Brandonh291/MRE481-Senior-Capstone-Project-Solar-Plane/Solar Charger/MPPT Circuit Board.png

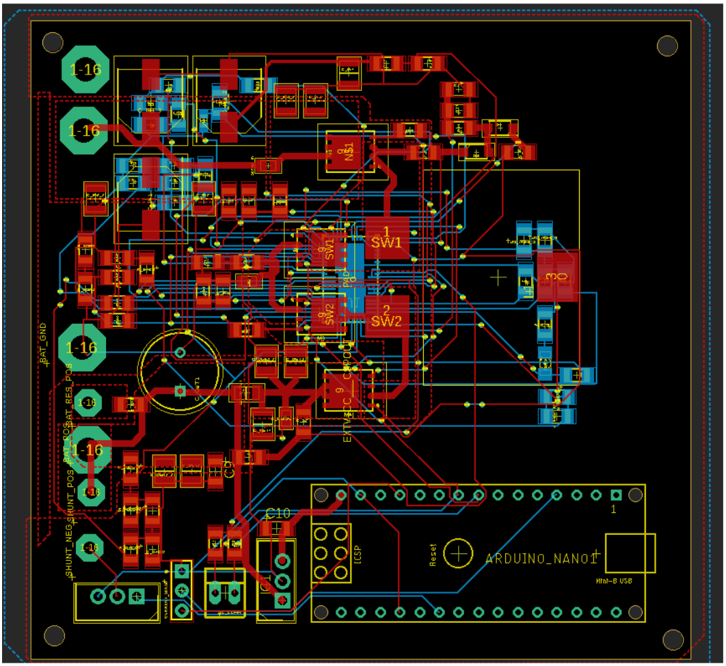
Solar Charger/MPPT Circuit Board.png
