Brandonh291/MRE481-Senior-Capstone-Project-Solar-Plane/README.md

# MRE481-Senior-Capstone-Project-Solar-Plane
