Brandonh291/MRE481-Senior-Capstone-Project-Solar-Plane/Solar Charger/MPPT Charging Circuit Design/Senior Design/Solar Charge Controller.png

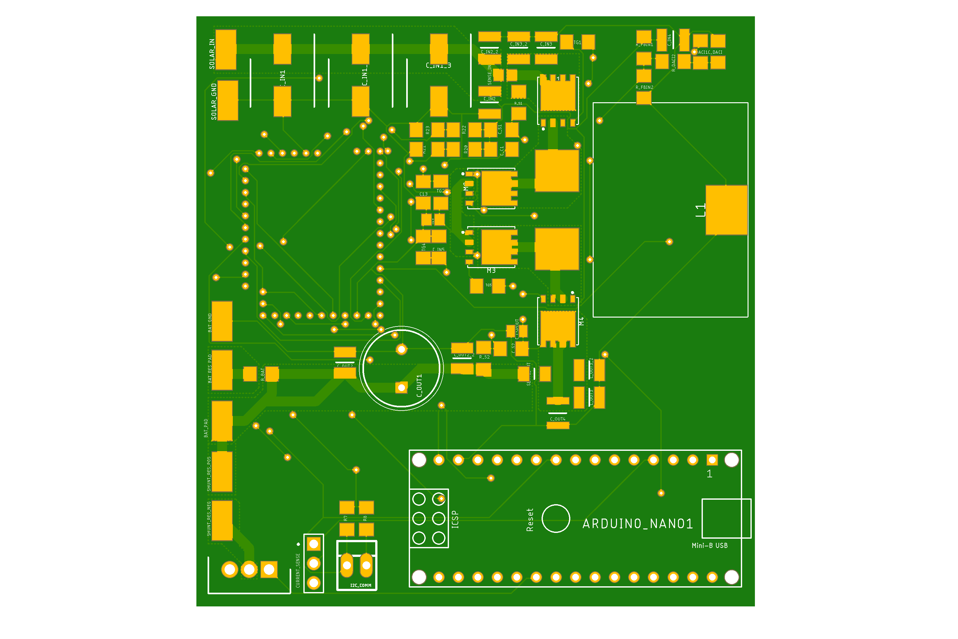
Solar Charger/MPPT Charging Circuit Design/Senior Design/Solar Charge Controller.png
