Brandonh291/MRE481-Senior-Capstone-Project-Solar-Plane/Solar Charger/Simulink Solar Charger and Battery Life Model.png

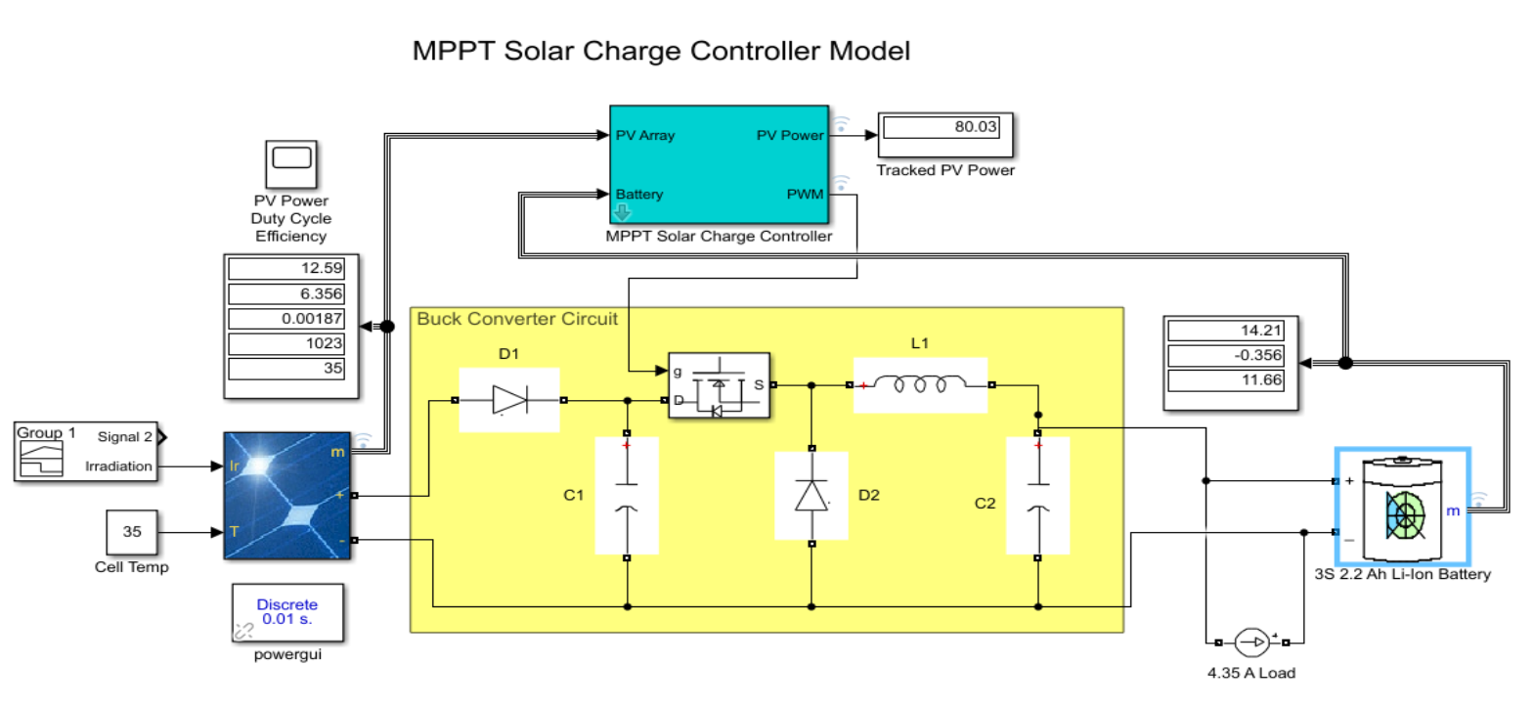
Solar Charger/Simulink Solar Charger and Battery Life Model.png
