Brandonh291/MRE481-Senior-Capstone-Project-Solar-Plane/Solar Charger/MPPT BOM.xlsx

Part | Cost per Part | Number Needed | Cost | Value | Link | Device | Package | Description | ARROW_PART_NUMBER | ARROW_PRICE-STOCK | BUILT_BY | COPYRIGHT | CREATED_BY | DESCRIPTION | DIGI_KEY_PART_NUMBER | HEIGHT | MANUFACTURER | MANUFACTURER_NAME | MANUFACTURER_PART_NUMBER | MF | MOUSER_PART_NUMBER | MOUSER_PRICE-STOCK | MPN | OC_FARNELL | OC_NEWARK | POPULARITY | SOURCELIBRARY | SPICEMODEL | SPICEPREFIX | SPICETYPE | VENDOR
ARDUINO_NANO1 | 4.95$ | 1 | 4.95$ |  |  | ARDUINO_NANO | ARDUINO_NANO | Arduino Nano V3.0
BAT_GND | 0$ | 0 | 0$ |  |  | SMD5 | SMD2,54-5,08 | SMD PAD |  |  |  |  |  |  |  |  |  |  |  |  |  |  |  |  |  | 21
BAT_PAD | 0.00$ | 0 | 0.00$ |  |  | SMD5 | SMD2,54-5,08 | SMD PAD |  |  |  |  |  |  |  |  |  |  |  |  |  |  |  |  |  | 21
BAT_RES_PAD | 0.00$ | 0 | 0.00$ |  |  | SMD5 | SMD2,54-5,08 | SMD PAD |  |  |  |  |  |  |  |  |  |  |  |  |  |  |  |  |  | 21
C1 | 0.12$ | 1 | 0.12$ | 100nF | https://www.mouser.com/ProductDetail/Vishay-Vitramon/VJ1206Y104JXAAR/ | CC1206 | C1206 | CAPACITOR, European symbol |  |  |  |  |  |  |  |  |  |  |  |  |  |  |  |  |  |  |  | NONE | C
C2 | 0.11$ | 1 | 0.11$ | 4.7uF x 2 | https://www.mouser.com/ProductDetail/Walsin/1206X475K250CT/ | CC1206 | C1206 | CAPACITOR, European symbol |  |  |  |  |  |  |  |  |  |  |  |  |  |  |  |  |  |  |  | NONE | C
C3 | 0.10$ | 1 | 0.10$ | 1uF | https://www.mouser.com/ProductDetail/Walsin/1206B105K250CT/ | CC1206 | C1206 | CAPACITOR, European symbol |  |  |  |  |  |  |  |  |  |  |  |  |  |  |  |  |  |  |  | NONE | C
C4 | 0.11$ | 1 | 0.11$ | 4.7uF | https://www.mouser.com/ProductDetail/Walsin/1206X475K250CT/ | CC1206 | C1206 | CAPACITOR, European symbol |  |  |  |  |  |  |  |  |  |  |  |  |  |  |  |  |  |  |  | NONE | C
C5 | 0.10$ | 1 | 0.10$ | 68nF | https://www.mouser.com/ProductDetail/Samsung-Electro-Mechanics/CL10B683KB8WPNC/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 | CC1206 | C0603 | CAPACITOR, European symbol |  |  |  |  |  |  |  |  |  |  |  |  |  |  |  |  |  |  |  | NONE | C
C6 | 0.10$ | 1 | 0.10$ | 220pF | https://www.mouser.com/ProductDetail/Walsin/1206B221K202CT/?qs=fIkAfuXiAQJKri8ChW5wGw%3D%3D | CC1206 | C1206 | CAPACITOR, European symbol |  |  |  |  |  |  |  |  |  |  |  |  |  |  |  |  |  |  |  | NONE | C
C7 | 0.10$ | 1 | 0.10$ | 8.2nF | https://www.mouser.com/ProductDetail/Walsin/1206B822K500CT/?qs=fIkAfuXiAQI%2FF3tws0uD%252BQ%3D%3D | CC1206 | C1206 | CAPACITOR, European symbol |  |  |  |  |  |  |  |  |  |  |  |  |  |  |  |  |  |  |  | NONE | C
C8 | 0.39$ | 1 | 0.39$ | 100nF | https://www.mouser.com/ProductDetail/Vishay-Vitramon/VJ1206Y104JXAAR/ | CC1206 | C1206 | CAPACITOR, European symbol |  |  |  |  |  |  |  |  |  |  |  |  |  |  |  |  |  |  |  | NONE | C
C11 | 0.11$ | 1 | 0.11$ | 4.7uF x 2 | https://www.mouser.com/ProductDetail/Walsin/1206X475K250CT/ | CC1206 | C1206 | CAPACITOR, European symbol |  |  |  |  |  |  |  |  |  |  |  |  |  |  |  |  |  |  |  | NONE | C
C13 | 0.11$ | 1 | 0.11$ | 3.3n | https://www.mouser.com/ProductDetail/Vishay-Vitramon/VJ1206Y332JXAAC/?qs=n%2FdCh0j7G57pZ1MJ9O0z7g%3D%3D | CC1206 | C1206 | CAPACITOR, European symbol |  |  |  |  |  |  |  |  |  |  |  |  |  |  |  |  |  |  |  | NONE | C
CURRENT_SENSE | 0.00$ | 0 | 0.00$ | 61300311121 | https://www.mouser.com/ProductDetail/Wurth-Elektronik/61300311121/ | 61300311121 | 61300311121 | CONN HEADER VERT 3POS 2.54MM |  |  |  |  | PCBLayout.com |  | 732-5316-ND |  | Wurth Electronics Inc. |  |  |  |  |  | 61300311121
C_C1 | 0.12$ | 1 | 0.12$ | 100nF | https://www.mouser.com/ProductDetail/Vishay-Vitramon/VJ1206Y104JXAAR/ | CC1206 | C1206 | CAPACITOR, European symbol |  |  |  |  |  |  |  |  |  |  |  |  |  |  |  |  |  |  |  | NONE | C
C_CSPOUT | 0.25$ | 1 | 0.25$ | 08055C104J4Z4A | https://www.mouser.com/ProductDetail/AVX/08055C104J4Z4A/?qs=xMTsDkQFXIw7L45hGtT%2Fjg%3D%3D | 08055C104J4Z4A | CAPC2012X127N | Cap Ceramic 0.1uF 50V X7R 5% SMD 0805 FlexiTerm 125C Paper T/R | 08055C104J4Z4A | https://www.arrow.com/en/products/08055c104j4z4a/avx |  |  |  | Cap Ceramic 0.1uF 50V X7R 5% SMD 0805 FlexiTerm 125C Paper T/R |  | 1.27mm |  | AVX | 08055C104J4Z4A |  | 581-08055C104J4Z4A | https://www.mouser.co.uk/ProductDetail/AVX/08055C104J4Z4A?qs=xMTsDkQFXIw7L45hGtT%2Fjg%3D%3D
C_DACI | 0.38$ | 1 | 0.38$ | 307nF | https://www.mouser.com/ProductDetail/Yageo/CC1206KKX7R0BB334/?qs=tS%2FAHvPQ%2F57JFCsk3C6blg%3D%3D | CC1206 | C1206 | CAPACITOR, European symbol |  |  |  |  |  |  |  |  |  |  |  |  |  |  |  |  |  |  |  | NONE | C
C_DACO | 0.33$ | 1 | 0.33$ | 81.445nF (82nF) | https://www.mouser.com/ProductDetail/AVX/12061C823KAT2A/?qs=iALvLSEVlb9T5XvBHTbaPA%3D%3D | CC1206 | C1206 | CAPACITOR, European symbol |  |  |  |  |  |  |  |  |  |  |  |  |  |  |  |  |  |  |  | NONE | C
C_IMON_IN | 0.10$ | 1 | 0.10$ | 10nF | https://www.mouser.com/ProductDetail/Walsin/1206B103K500CT/?qs=fIkAfuXiAQIBfhuh%2Ff3kSw%3D%3D | CC1206 | C1206 | CAPACITOR, European symbol |  |  |  |  |  |  |  |  |  |  |  |  |  |  |  |  |  |  |  | NONE | C
C_IMON_OUT | 0.10$ | 1 | 0.10$ | 10nF | https://www.mouser.com/ProductDetail/Walsin/1206B103K500CT/?qs=fIkAfuXiAQIBfhuh%2Ff3kSw%3D%3D | CC1206 | C1206 | CAPACITOR, European symbol |  |  |  |  |  |  |  |  |  |  |  |  |  |  |  |  |  |  |  | NONE | C
C_IN1 | 3.30$ | 1 | 3.30$ | 63HVH33M | https://www.mouser.com/ProductDetail/Panasonic/63SXV33M/?qs=LkACrQhHtvC3OEKZ9h0MUg%3D%3D | 63HVH33M | CAPAE1025X1080N | Hybrid Conductive Polymer Type / Surface Mount Type |  |  |  |  |  | Hybrid Conductive Polymer Type / Surface Mount Type |  | 10.8mm |  | SANYO | 63HVH33M
C_IN1_2 | 3.30$ | 1 | 3.30$ | 63HVH33M | https://www.mouser.com/ProductDetail/Panasonic/63SXV33M/?qs=LkACrQhHtvC3OEKZ9h0MUg%3D%3D | 63HVH33M | CAPAE1025X1080N | Hybrid Conductive Polymer Type / Surface Mount Type |  |  |  |  |  | Hybrid Conductive Polymer Type / Surface Mount Type |  | 10.8mm |  | SANYO | 63HVH33M
C_IN1_3 | 3.30$ | 1 | 3.30$ | 63HVH33M | https://www.mouser.com/ProductDetail/Panasonic/63SXV33M/?qs=LkACrQhHtvC3OEKZ9h0MUg%3D%3D | 63HVH33M | CAPAE1025X1080N | Hybrid Conductive Polymer Type / Surface Mount Type |  |  |  |  |  | Hybrid Conductive Polymer Type / Surface Mount Type |  | 10.8mm |  | SANYO | 63HVH33M
C_IN2 | 0.25$ | 1 | 0.25$ | 2.2uf x 2 | https://www.mouser.com/ProductDetail/187-CL31B225KBHNFNE/ | 12101C225KAT2A | CAPC3325X279N | AVX 1210 Standard 2.2 | 12101C225KAT2A | https://www.arrow.com/en/products/12101c225kat2a/avx |  |  |  | AVX 1210 Standard 2.2 |  | 2.79mm |  | AVX | 12101C225KAT2A |  | 581-12101C225KAT2A | https://www.mouser.co.uk/ProductDetail/AVX/12101C225KAT2A?qs=sEn5VCT5Piadpj%252BmhssWtA%3D%3D
C_IN2_2 | 0.25$ | 1 | 0.25$ | 2.2uf x 2 | https://www.mouser.com/ProductDetail/187-CL31B225KBHNFNE/ | 12101C225KAT2A | CAPC3325X279N | AVX 1210 Standard 2.2 | 12101C225KAT2A | https://www.arrow.com/en/products/12101c225kat2a/avx |  |  |  | AVX 1210 Standard 2.2 |  | 2.79mm |  | AVX | 12101C225KAT2A |  | 581-12101C225KAT2A | https://www.mouser.co.uk/ProductDetail/AVX/12101C225KAT2A?qs=sEn5VCT5Piadpj%252BmhssWtA%3D%3D
C_IN3 | 0.25$ | 1 | 0.25$ | 2.2uf x 2 | https://www.mouser.com/ProductDetail/187-CL31B225KBHNFNE/ | 12101C225KAT2A | CAPC3325X279N | AVX 1210 Standard 2.2 | 12101C225KAT2A | https://www.arrow.com/en/products/12101c225kat2a/avx |  |  |  | AVX 1210 Standard 2.2 |  | 2.79mm |  | AVX | 12101C225KAT2A |  | 581-12101C225KAT2A | https://www.mouser.co.uk/ProductDetail/AVX/12101C225KAT2A?qs=sEn5VCT5Piadpj%252BmhssWtA%3D%3D
C_IN3_2 | 0.25$ | 1 | 0.25$ | 2.2uf x 2 | https://www.mouser.com/ProductDetail/187-CL31B225KBHNFNE/ | 12101C225KAT2A | CAPC3325X279N | AVX 1210 Standard 2.2 | 12101C225KAT2A | https://www.arrow.com/en/products/12101c225kat2a/avx |  |  |  | AVX 1210 Standard 2.2 |  | 2.79mm |  | AVX | 12101C225KAT2A |  | 581-12101C225KAT2A | https://www.mouser.co.uk/ProductDetail/AVX/12101C225KAT2A?qs=sEn5VCT5Piadpj%252BmhssWtA%3D%3D
C_IN4 | 0.25$ | 1 | 0.25$ | 2.2uf | https://www.mouser.com/ProductDetail/187-CL31B225KBHNFNE/ | 12101C225KAT2A | CAPC3325X279N | AVX 1210 Standard 2.2 | 12101C225KAT2A | https://www.arrow.com/en/products/12101c225kat2a/avx |  |  |  | AVX 1210 Standard 2.2 |  | 2.79mm |  | AVX | 12101C225KAT2A |  | 581-12101C225KAT2A | https://www.mouser.co.uk/ProductDetail/AVX/12101C225KAT2A?qs=sEn5VCT5Piadpj%252BmhssWtA%3D%3D
C_IN5 | 0.11$ | 1 | 0.11$ | 3.3n | https://www.mouser.com/ProductDetail/Vishay-Vitramon/VJ1206Y332JXAAC/?qs=n%2FdCh0j7G57pZ1MJ9O0z7g%3D%3D | CC1206 | C1206 | CAPACITOR, European symbol |  |  |  |  |  |  |  |  |  |  |  |  |  |  |  |  |  |  |  | NONE | C
C_IN6 | 0.10$ | 1 | 0.10$ | 220n | https://www.mouser.com/ProductDetail/Walsin/1206B224K500CT/ | CC1206 | C1206 | CAPACITOR, European symbol |  |  |  |  |  |  |  |  |  |  |  |  |  |  |  |  |  |  |  | NONE | C
C_IN7 | 0.10$ | 1 | 0.10$ | 220n | https://www.mouser.com/ProductDetail/Walsin/1206B224K500CT/ | CC1206 | C1206 | CAPACITOR, European symbol |  |  |  |  |  |  |  |  |  |  |  |  |  |  |  |  |  |  |  | NONE | C
C_OUT1 | 0.71$ | 1 | 0.71$ | EEUFR1H151B | https://www.mouser.com/ProductDetail/Panasonic/EEU-FR1H151B/ | EEUFR1H151B | CAPPRD500W65D1000H1400 | Cap Aluminum Lytic 150uF 50V 20% (10 X 12.5mm) Radial 5mm 1170mA 6000h 105C Ammo |  |  |  |  |  | Cap Aluminum Lytic 150uF 50V 20% (10 X 12.5mm) Radial 5mm 1170mA 6000h 105C Ammo |  | 14mm |  | Panasonic | EEUFR1H151B
C_OUT2 | 1.06$ | 1 | 1.06$ | GRM32ER7YA106KA12K | https://www.mouser.com/ProductDetail/Murata-Electronics/GRM32ER7YA106KA12K/ | GRM32ER7YA106KA12K | CAPC3225X270N | Multilayer Ceramic Capacitors MLCC - SMD/SMT | GRM32ER7YA106KA12K | https://www.arrow.com/en/products/grm32er7ya106ka12k/murata-manufacturing |  |  |  | Multilayer Ceramic Capacitors MLCC - SMD/SMT |  | 2.7mm |  | Murata Electronics | GRM32ER7YA106KA12K |  | 81-GRM32ER7YA106KA2K | https://www.mouser.com/Search/Refine.aspx?Keyword=81-GRM32ER7YA106KA2K
C_OUT2_2 | 1.06$ | 1 | 1.06$ | GRM32ER7YA106KA12K | https://www.mouser.com/ProductDetail/Murata-Electronics/GRM32ER7YA106KA12K/ | GRM32ER7YA106KA12K | CAPC3225X270N | Multilayer Ceramic Capacitors MLCC - SMD/SMT | GRM32ER7YA106KA12K | https://www.arrow.com/en/products/grm32er7ya106ka12k/murata-manufacturing |  |  |  | Multilayer Ceramic Capacitors MLCC - SMD/SMT |  | 2.7mm |  | Murata Electronics | GRM32ER7YA106KA12K |  | 81-GRM32ER7YA106KA2K | https://www.mouser.com/Search/Refine.aspx?Keyword=81-GRM32ER7YA106KA2K
C_OUT3 | 1.06$ | 1 | 1.06$ | GRM32ER7YA106KA12K | https://www.mouser.com/ProductDetail/Murata-Electronics/GRM32ER7YA106KA12K/ | GRM32ER7YA106KA12K | CAPC3225X270N | Multilayer Ceramic Capacitors MLCC - SMD/SMT | GRM32ER7YA106KA12K | https://www.arrow.com/en/products/grm32er7ya106ka12k/murata-manufacturing |  |  |  | Multilayer Ceramic Capacitors MLCC - SMD/SMT |  | 2.7mm |  | Murata Electronics | GRM32ER7YA106KA12K |  | 81-GRM32ER7YA106KA2K | https://www.mouser.com/Search/Refine.aspx?Keyword=81-GRM32ER7YA106KA2K
C_OUT3_2 | 1.06$ | 1 | 1.06$ | GRM32ER7YA106KA12K | https://www.mouser.com/ProductDetail/Murata-Electronics/GRM32ER7YA106KA12K/ | GRM32ER7YA106KA12K | CAPC3225X270N | Multilayer Ceramic Capacitors MLCC - SMD/SMT | GRM32ER7YA106KA12K | https://www.arrow.com/en/products/grm32er7ya106ka12k/murata-manufacturing |  |  |  | Multilayer Ceramic Capacitors MLCC - SMD/SMT |  | 2.7mm |  | Murata Electronics | GRM32ER7YA106KA12K |  | 81-GRM32ER7YA106KA2K | https://www.mouser.com/Search/Refine.aspx?Keyword=81-GRM32ER7YA106KA2K
C_OUT4 | 0.34$ | 1 | 0.34$ | CGA6L2X7R1H105K160AA | https://www.mouser.com/ProductDetail/TDK/CGA6L2X7R1H105K160AA/ | CGA6L2X7R1H105K160AA | CAPC3225X280N | TDK CGA6L2X7R1H105K160AA 1F MLCC 50V dc +/-10% Tolerance SMD | CGA6L2X7R1H105K160AA | https://www.arrow.com/en/products/cga6l2x7r1h105k160aa/tdk |  |  |  | TDK CGA6L2X7R1H105K160AA 1F MLCC 50V dc +/-10% Tolerance SMD |  | 2.8mm |  | TDK | CGA6L2X7R1H105K160AA |  | 810-CGA6L2X7R1H105K | https://www.mouser.com/Search/Refine.aspx?Keyword=810-CGA6L2X7R1H105K
C_S1 | 0.16$ | 1 | 0.16$ | 470n | https://www.mouser.com/ProductDetail/Vishay-Vitramon/VJ1206Y474KXATW1BC/ | CC1206 | C1206 | CAPACITOR, European symbol |  |  |  |  |  |  |  |  |  |  |  |  |  |  |  |  |  |  |  | NONE | C
C_S2 | 0.16$ | 1 | 0.16$ | 470nF | https://www.mouser.com/ProductDetail/Vishay-Vitramon/VJ1206Y474KXATW1BC/ | CC1206 | C1206 | CAPACITOR, European symbol |  |  |  |  |  |  |  |  |  |  |  |  |  |  |  |  |  |  |  | NONE | C
D3 | 0.83$ | 1 | 0.83$ | CMMR1U-02_TR | https://www.mouser.com/ProductDetail/Central-Semiconductor/CMMR1U-02-TR-PBFREE/ | CMMR1U-02_TR | SODFL3818X108N | Rectifiers Ultra Fast Rectifier Single |  |  |  |  |  | Rectifiers Ultra Fast Rectifier Single |  | 1.08mm |  | Central Semiconductor | CMMR1U-02 TR |  | 610-CMMR1U-02 | https://www.mouser.com/Search/Refine.aspx?Keyword=610-CMMR1U-02
D4 | 0.83$ | 1 | 0.83$ | CMMR1U-02_TR | https://www.mouser.com/ProductDetail/Central-Semiconductor/CMMR1U-02-TR-PBFREE/ | CMMR1U-02_TR | SODFL3818X108N | Rectifiers Ultra Fast Rectifier Single |  |  |  |  |  | Rectifiers Ultra Fast Rectifier Single |  | 1.08mm |  | Central Semiconductor | CMMR1U-02 TR |  | 610-CMMR1U-02 | https://www.mouser.com/Search/Refine.aspx?Keyword=610-CMMR1U-02
D_S | 0.43$ | 1 | 0.43$ | MMBT5550L | https://www.mouser.com/ProductDetail/Stanley-Electric/BG1102W-TR/?qs=byeeYqUIh0NA%2FIv6R5YGDA%3D%3D | LED_E | LED_1206 | LED |  |  |  |  |  |  |  |  |  |  |  |  |  |  |  |  |  |  |  | NONE | D | diode
I2C_COMM | 0.16$ | 1 | 0.16$ | 22-23-2021 | https://www.mouser.com/ProductDetail/Molex/22-23-2021/ | 22-23-2021 | 22-23-2021 | .100 (2.54mm) Center Header - 2 Pin" |  |  |  |  |  |  |  |  |  |  |  | MOLEX |  |  | 22-23-2021 | 1462926 | 25C3832 | 40
L1 | 4.87$ | 1 | 4.87$ | 10u | https://www.mouser.com/ProductDetail/Coilcraft/SER2915H-103KL/ | SER2915H-103KL | SER2900 | Fixed Inductors SER2915H Hi Current 10 uH 10 % 30 A |  |  |  |  |  | Fixed Inductors SER2915H Hi Current 10 uH 10 % 30 A |  | mm |  | COILCRAFT | SER2915H-103KL |  | 994-SER2915H-103KL | https://www.mouser.co.uk/ProductDetail/Coilcraft/SER2915H-103KL?qs=zCSbvcPd3pbm6JOcdM0KSg%3D%3D
M1 | 0.83$ | 1 | 0.83$ | BSC028N06NS | https://www.mouser.com/ProductDetail/Infineon-Technologies/BSC028N06NS/?qs=EUA%2Fg8wssK3HptIwN0%252BK7A%3D%3D | BSC028N06NS | PG-TDSON-8_1 | MOSFET N-Channel 60V 100A OptiMOS TDSON8 Infineon BSC028N06NS N-channel MOSFET Transistor, 100 A, 60 V, 8-Pin TDSON |  |  |  |  |  | MOSFET N-Channel 60V 100A OptiMOS TDSON8 Infineon BSC028N06NS N-channel MOSFET Transistor, 100 A, 60 V, 8-Pin TDSON |  | mm |  | Infineon | BSC028N06NS |  | 726-BSC028N06NS | https://www.mouser.co.uk/ProductDetail/Infineon-Technologies/BSC028N06NS?qs=EUA%2Fg8wssK3HptIwN0%252BK7A%3D%3D
M2 | 0.83$ | 1 | 0.83$ | BSC028N06NS | https://www.mouser.com/ProductDetail/Infineon-Technologies/BSC028N06NS/?qs=EUA%2Fg8wssK3HptIwN0%252BK7A%3D%3D | BSC028N06NS | PG-TDSON-8_1 | MOSFET N-Channel 60V 100A OptiMOS TDSON8 Infineon BSC028N06NS N-channel MOSFET Transistor, 100 A, 60 V, 8-Pin TDSON |  |  |  |  |  | MOSFET N-Channel 60V 100A OptiMOS TDSON8 Infineon BSC028N06NS N-channel MOSFET Transistor, 100 A, 60 V, 8-Pin TDSON |  | mm |  | Infineon | BSC028N06NS |  | 726-BSC028N06NS | https://www.mouser.co.uk/ProductDetail/Infineon-Technologies/BSC028N06NS?qs=EUA%2Fg8wssK3HptIwN0%252BK7A%3D%3D
M3 | 0.83$ | 1 | 0.83$ | BSC059N04LSGATMA1 | https://www.mouser.com/ProductDetail/Infineon-Technologies/BSC059N04LSGATMA1/?qs=OwbwYO03UsIeXsXqrPLFnQ%3D%3D | BSC059N04LSGATMA1 | BSC080N03LSG | MOSFET N-Ch 40V 73A TDSON-8 OptiMOS 3 | BSC059N04LSGATMA1 | https://www.arrow.com/en/products/bsc059n04lsgatma1/infineon-technologies-ag |  |  |  | MOSFET N-Ch 40V 73A TDSON-8 OptiMOS 3 |  | mm |  | Infineon | BSC059N04LSGATMA1 |  | 726-BSC059N04LSGATMA | https://www.mouser.co.uk/ProductDetail/Infineon-Technologies/BSC059N04LSGATMA1/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
M4 | 0.83$ | 1 | 0.83$ | BSC059N04LSGATMA1 | https://www.mouser.com/ProductDetail/Infineon-Technologies/BSC059N04LSGATMA1/?qs=OwbwYO03UsIeXsXqrPLFnQ%3D%3D | BSC059N04LSGATMA1 | BSC080N03LSG | MOSFET N-Ch 40V 73A TDSON-8 OptiMOS 3 | BSC059N04LSGATMA1 | https://www.arrow.com/en/products/bsc059n04lsgatma1/infineon-technologies-ag |  |  |  | MOSFET N-Ch 40V 73A TDSON-8 OptiMOS 3 |  | mm |  | Infineon | BSC059N04LSGATMA1 |  | 726-BSC059N04LSGATMA | https://www.mouser.co.uk/ProductDetail/Infineon-Technologies/BSC059N04LSGATMA1/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
R4 | 0.11$ | 1 | 0.11$ | 200k | https://www.mouser.com/ProductDetail/Bourns/CR1206AFX-2003ELF/ | RR1206 | R1206 | RESISTOR, European symbol |  |  |  |  |  |  |  |  |  |  |  |  |  |  |  |  |  |  |  | NONE | R
R5 | 0.10$ | 1 | 0.10$ | 10k | https://www.mouser.com/ProductDetail/Vishay-Dale/CRCW120610K0FKEAC/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 | RR1206 | R1206 | RESISTOR, European symbol |  |  |  |  |  |  |  |  |  |  |  |  |  |  |  |  |  |  |  | NONE | R
R6 | 0.10$ | 1 | 0.10$ | 18.2k | https://www.mouser.com/ProductDetail/Bourns/CR1206-FX-1822ELF/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 | RR1206 | R1206 | RESISTOR, European symbol |  |  |  |  |  |  |  |  |  |  |  |  |  |  |  |  |  |  |  | NONE | R
R7 | 0.10$ | 1 | 0.10$ | 10k | https://www.mouser.com/ProductDetail/Vishay-Dale/CRCW120610K0FKEAC/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 | RR1206 | R1206 | RESISTOR, European symbol |  |  |  |  |  |  |  |  |  |  |  |  |  |  |  |  |  |  |  | NONE | R
R8 | 0.10$ | 1 | 0.10$ | 10k | https://www.mouser.com/ProductDetail/Vishay-Dale/CRCW120610K0FKEAC/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 | RR1206 | R1206 | RESISTOR, European symbol |  |  |  |  |  |  |  |  |  |  |  |  |  |  |  |  |  |  |  | NONE | R
R9 | 0.10$ | 1 | 0.10$ | 1.3k | https://www.mouser.com/ProductDetail/Vishay-Dale/CRCW12061K30FKEAC/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 | RR1206 | R1206 | RESISTOR, European symbol |  |  |  |  |  |  |  |  |  |  |  |  |  |  |  |  |  |  |  | NONE | R
R10 | 0.10$ | 1 | 0.10$ | 100k | https://www.mouser.com/ProductDetail/Vishay-Dale/CRCW1206100KFKEAC/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 | RR1206 | R1206 | RESISTOR, European symbol |  |  |  |  |  |  |  |  |  |  |  |  |  |  |  |  |  |  |  | NONE | R
R12 | 0.10$ | 1 | 0.10$ | 53.6k | https://www.mouser.com/ProductDetail/Panasonic/ERJ-8ENF5362V/ | RR1206 | R1206 | RESISTOR, European symbol |  |  |  |  |  |  |  |  |  |  |  |  |  |  |  |  |  |  |  | NONE | R
R13 | 0.10$ | 1 | 0.10$ | 10k | https://www.mouser.com/ProductDetail/Vishay-Dale/CRCW120610K0FKEAC/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 | RR1206 | R1206 | RESISTOR, European symbol |  |  |  |  |  |  |  |  |  |  |  |  |  |  |  |  |  |  |  | NONE | R
R18 | 0.10$ | 1 | 0.10$ | 215k | https://www.mouser.com/ProductDetail/Vishay-Dale/CRCW1206215KFKEA/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 | RR1206 | R1206 | RESISTOR, European symbol |  |  |  |  |  |  |  |  |  |  |  |  |  |  |  |  |  |  |  | NONE | R
R20 | 0.10$ | 1 | 0.10$ | 196k | https://www.mouser.com/ProductDetail/KOA-Speer/RK73H2BTTD1963F/ | RR1206 | R1206 | RESISTOR, European symbol |  |  |  |  |  |  |  |  |  |  |  |  |  |  |  |  |  |  |  | NONE | R
R21 | 0.10$ | 1 | 0.10$ | 8.06k | https://www.mouser.com/ProductDetail/Bourns/CR1206-FX-8061ELF/ | RR1206 | R1206 | RESISTOR, European symbol |  |  |  |  |  |  |  |  |  |  |  |  |  |  |  |  |  |  |  | NONE | R
R22 | 0.10$ | 1 | 0.10$ | 110k | https://www.mouser.com/ProductDetail/Bourns/CR1206-JW-114ELF/ | RR1206 | R1206 | RESISTOR, European symbol |  |  |  |  |  |  |  |  |  |  |  |  |  |  |  |  |  |  |  | NONE | R
R23 | 0.10$ | 1 | 0.10$ | 35.7k | https://www.mouser.com/ProductDetail/Vishay-Dale/CRCW120635K7FKEA/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 | RR1206 | R1206 | RESISTOR, European symbol |  |  |  |  |  |  |  |  |  |  |  |  |  |  |  |  |  |  |  | NONE | R
R24 | 0.13$ | 1 | 0.13$ | 4 (4.02) | https://www.mouser.com/ProductDetail/Vishay-Dale/CRCW12064R02FNEA/ | RR1206 | R1206 | RESISTOR, European symbol |  |  |  |  |  |  |  |  |  |  |  |  |  |  |  |  |  |  |  | NONE | R
R_BAT | 0.10$ | 1 | 0.10$ | 100 | https://www.mouser.com/ProductDetail/KOA-Speer/RK73H2BTTD1000F/ | RR1206 | R1206 | RESISTOR, European symbol |  |  |  |  |  |  |  |  |  |  |  |  |  |  |  |  |  |  |  | NONE | R
R_DACI1 | 0.10$ | 1 | 0.10$ | 3.26k (3.24k) | https://www.mouser.com/ProductDetail/Vishay-Dale/CRCW12063K24FKEA/ | RR1206 | R1206 | RESISTOR, European symbol |  |  |  |  |  |  |  |  |  |  |  |  |  |  |  |  |  |  |  | NONE | R
R_DACI2 | 0.10$ | 1 | 0.10$ | 16.3k (16.2k) | https://www.mouser.com/ProductDetail/Panasonic/ERJ-8ENF1622V/ | RR1206 | R1206 | RESISTOR, European symbol |  |  |  |  |  |  |  |  |  |  |  |  |  |  |  |  |  |  |  | NONE | R
R_DACO1 | 0.10$ | 1 | 0.10$ | 24.557k (24.3k) | https://www.mouser.com/ProductDetail/Vishay-Dale/CRCW120624K3FKEA/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 | RR1206 | R1206 | RESISTOR, European symbol |  |  |  |  |  |  |  |  |  |  |  |  |  |  |  |  |  |  |  | NONE | R
R_DACO2 | 0.10$ | 1 | 0.10$ | 122.78k | https://www.mouser.com/ProductDetail/Vishay-Dale/CRCW1206124KFKEAC/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 | RR1206 | R1206 | RESISTOR, European symbol |  |  |  |  |  |  |  |  |  |  |  |  |  |  |  |  |  |  |  | NONE | R
R_DSA | 0.10$ | 1 | 0.10$ | 549 | https://www.mouser.com/ProductDetail/Bourns/CR1206-FX-5490ELF/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 | RR1206 | R1206 | RESISTOR, European symbol |  |  |  |  |  |  |  |  |  |  |  |  |  |  |  |  |  |  |  | NONE | R
R_FBIN1 | 0.11$ | 1 | 0.11$ | 94.8k | https://www.mouser.com/ProductDetail/Bourns/CR1206-FX-95R3ELF/ | RR1206 | R1206 | RESISTOR, European symbol |  |  |  |  |  |  |  |  |  |  |  |  |  |  |  |  |  |  |  | NONE | R
R_FBIN2 | 0.11$ | 1 | 0.11$ | 7.6k (7.68k) | https://www.mouser.com/ProductDetail/Bourns/CR1206-FX-7681ELF/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 | RR1206 | R1206 | RESISTOR, European symbol |  |  |  |  |  |  |  |  |  |  |  |  |  |  |  |  |  |  |  | NONE | R
R_FBOUT1 | 0.10$ | 1 | 0.10$ | 225.84k (226k) | https://www.mouser.com/ProductDetail/Vishay-Dale/CRCW1206226KFKEA/ | RR1206 | R1206 | RESISTOR, European symbol |  |  |  |  |  |  |  |  |  |  |  |  |  |  |  |  |  |  |  | NONE | R
R_FBOUT2 | 0.10$ | 1 | 0.10$ | 23.2k | https://www.mouser.com/ProductDetail/Vishay-Dale/CRCW120623K2FKEA/ | RR1206 | R1206 | RESISTOR, European symbol |  |  |  |  |  |  |  |  |  |  |  |  |  |  |  |  |  |  |  | NONE | R
R_IMON_IN | 0.11$ | 1 | 0.11$ | 21k | https://www.mouser.com/ProductDetail/Bourns/CR1206-FX-2102ELF/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 | RR1206 | R1206 | RESISTOR, European symbol |  |  |  |  |  |  |  |  |  |  |  |  |  |  |  |  |  |  |  | NONE | R
R_IMON_OUT | 0.10$ | 1 | 0.10$ | 121.53k (121k) | https://www.mouser.com/ProductDetail/Vishay-Dale/CRCW1206121KFKEA/ | RR1206 | R1206 | RESISTOR, European symbol |  |  |  |  |  |  |  |  |  |  |  |  |  |  |  |  |  |  |  | NONE | R
R_IOR | 0.10$ | 1 | 0.10$ | 3.01k | https://www.mouser.com/ProductDetail/Vishay-Dale/CRCW12063K01FKEAC/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 | RR1206 | R1206 | RESISTOR, European symbol |  |  |  |  |  |  |  |  |  |  |  |  |  |  |  |  |  |  |  | NONE | R
R_IOW | 0.10$ | 1 | 0.10$ | 30.373k (30.1k) | https://www.mouser.com/ProductDetail/Vishay-Dale/CRCW120630K1FKEAC/ | RR1206 | R1206 | RESISTOR, European symbol |  |  |  |  |  |  |  |  |  |  |  |  |  |  |  |  |  |  |  | NONE | R
R_S1 | 0.10$ | 1 | 0.10$ | 22 | https://www.mouser.com/ProductDetail/Vishay-Dale/CRCW120622R0FKEAC/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 | RR1206 | R1206 | RESISTOR, European symbol |  |  |  |  |  |  |  |  |  |  |  |  |  |  |  |  |  |  |  | NONE | R
R_S2 | 0.10$ | 1 | 0.10$ | 22 | https://www.mouser.com/ProductDetail/Vishay-Dale/CRCW120622R0FKEAC/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 | RR1206 | R1206 | RESISTOR, European symbol |  |  |  |  |  |  |  |  |  |  |  |  |  |  |  |  |  |  |  | NONE | R
R_SENS2_1/2W | 0.34$ | 1 | 0.34$ | 5m | https://www.mouser.com/ProductDetail/Ohmite/PCS1206FR0050ET/?qs=sGAEpiMZZMtlubZbdhIBIGHLgUcK9TXf55488EjCMdA%3D | ERJ-MP2MF5M0U | RESC3216X89N | Panasonic ERJMP2 Series Metal Plate Current Sensing Surface Mount Resistor 1206 Case 5m +/-1% 1W +/-75ppm/C |  |  |  |  |  | Panasonic ERJMP2 Series Metal Plate Current Sensing Surface Mount Resistor 1206 Case 5m +/-1% 1W +/-75ppm/C |  | 0.89mm |  | Panasonic | ERJ-MP2MF5M0U |  | 667-ERJ-MP2MF5M0U | https://www.mouser.com/Search/Refine.aspx?Keyword=667-ERJ-MP2MF5M0U
R_SENSE1_1/2W | 0.63$ | 1 | 0.63$ | 6.2m | https://www.mouser.com/ProductDetail/Panasonic/ERJ-6LWFR006V/ | ERJ6LWFR006V | RESC2012X80N | Res Current Sense Thick Film 0805 0.006 Ohm 1% 1/2W 0ppm/C to 300ppm/C Molded Paper T/R - Tape and Reel |  |  |  |  |  | Res Current Sense Thick Film 0805 0.006 Ohm 1% 1/2W 0ppm/C to 300ppm/C Molded Paper T/R - Tape and Reel |  | 0.8mm |  | Panasonic | ERJ6LWFR006V
SHUNT_NFET | 1.26$ | 1 | 1.26$ | RFP30N06LE | https://www.mouser.com/ProductDetail/?qs=xG1VSrP1u4p07AnJbhQNHg%3D%3D | RFP30N06LE | TO254P470X1016X2019-3P | MOSFET TO-220AB N-Ch Power |  |  |  |  |  | MOSFET TO-220AB N-Ch Power |  | 4.7mm |  | ON Semiconductor | RFP30N06LE |  | 512-RFP30N06LE | https://www.mouser.co.uk/ProductDetail/ON-Semiconductor-Fairchild/RFP30N06LE?qs=mdiO5HdF0KgGbixxeJqneA%3D%3D
SHUNT_RES_NEG | 0.00$ | 0 | 0.00$ |  |  | SMD5 | SMD2,54-5,08 | SMD PAD |  |  |  |  |  |  |  |  |  |  |  |  |  |  |  |  |  | 21
SHUNT_RES_POS | 0.00$ | 0 | 0.00$ |  |  | SMD5 | SMD2,54-5,08 | SMD PAD |  |  |  |  |  |  |  |  |  |  |  |  |  |  |  |  |  | 21
SOLAR_GND | 0.00$ | 0 | 0.00$ |  |  | SMD5 | SMD2,54-5,08 | SMD PAD |  |  |  |  |  |  |  |  |  |  |  |  |  |  |  |  |  | 21
SOLAR_IN | 0.00$ | 0 | 0.00$ |  |  | SMD5 | SMD2,54-5,08 | SMD PAD |  |  |  |  |  |  |  |  |  |  |  |  |  |  |  |  |  | 21
TG1 | 0.10$ | 1 | 0.10$ | 2 | https://www.mouser.com/ProductDetail/Vishay-Dale/CRCW12062R00FKEA/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 | RR1206 | R1206 | RESISTOR, European symbol |  |  |  |  |  |  |  |  |  |  |  |  |  |  |  |  |  |  |  | NONE | R
TG2 | 0.10$ | 1 | 0.10$ | 10 | https://www.mouser.com/ProductDetail/Vishay-Dale/CRCW120610R0FKEA/ | RR1206 | R1206 | RESISTOR, European symbol |  |  |  |  |  |  |  |  |  |  |  |  |  |  |  |  |  |  |  | NONE | R
TG3 | 0.63$ | 1 | 0.63$ | 6m | https://www.mouser.com/ProductDetail/Panasonic/ERJ-6LWFR006V/ | ERJ6LWFR006V | RESC2012X80N | Res Current Sense Thick Film 0805 0.006 Ohm 1% 1/2W 0ppm/C to 300ppm/C Molded Paper T/R - Tape and Reel |  |  |  |  |  | Res Current Sense Thick Film 0805 0.006 Ohm 1% 1/2W 0ppm/C to 300ppm/C Molded Paper T/R - Tape and Reel |  | 0.8mm |  | Panasonic | ERJ6LWFR006V
TG4 | 0.10$ | 1 | 0.10$ | 10 | https://www.mouser.com/ProductDetail/Vishay-Dale/CRCW120610R0FKEA/ | RR1206 | R1206 | RESISTOR, European symbol |  |  |  |  |  |  |  |  |  |  |  |  |  |  |  |  |  |  |  | NONE | R
TG5 | 0.10$ | 1 | 0.10$ | 2 | https://www.mouser.com/ProductDetail/Vishay-Dale/CRCW12062R00FKEA/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 | RR1206 | R1206 | RESISTOR, European symbol |  |  |  |  |  |  |  |  |  |  |  |  |  |  |  |  |  |  |  | NONE | R
U1 | 20.65$ | 1 | 20.65$ | LT8491EUKJ | https://www.mouser.com/ProductDetail/Analog-Devices/LT8491EUKJPBF/ | LT8491EUKJ | QFN64(58)-UKJ-REV0_ADI |  |  |  | SunStream | Copyright (C) 2018 Accelerated Designs. All rights reserved |  |  |  |  |  |  | LT8491EUKJ |  |  |  |  |  |  |  | Analog_Devices_Inc_2020-09-15 |  |  |  | Analog Devices Inc
Shunt Resistor | 9.26$ | 1 | 9.26$ |  | https://www.mouser.com/ProductDetail/ARCOL-Ohmite/HS100E6-1R5-F-M193/?qs=B6kkDfuK7%2FDoDD9aVZCujQ%3D%3D
Total Cost | 71.43$
