Brandonh291/MRE481-Senior-Capstone-Project-Solar-Plane/Solar Charger/MPPT Charging Circuit Design/Senior Design/Solar Charge Controller_ver2.brd

## EAGLE design Solar Charger/MPPT Charging Circuit Design/Senior Design/Solar Charge Controller_ver2.brd (2023-08-01)

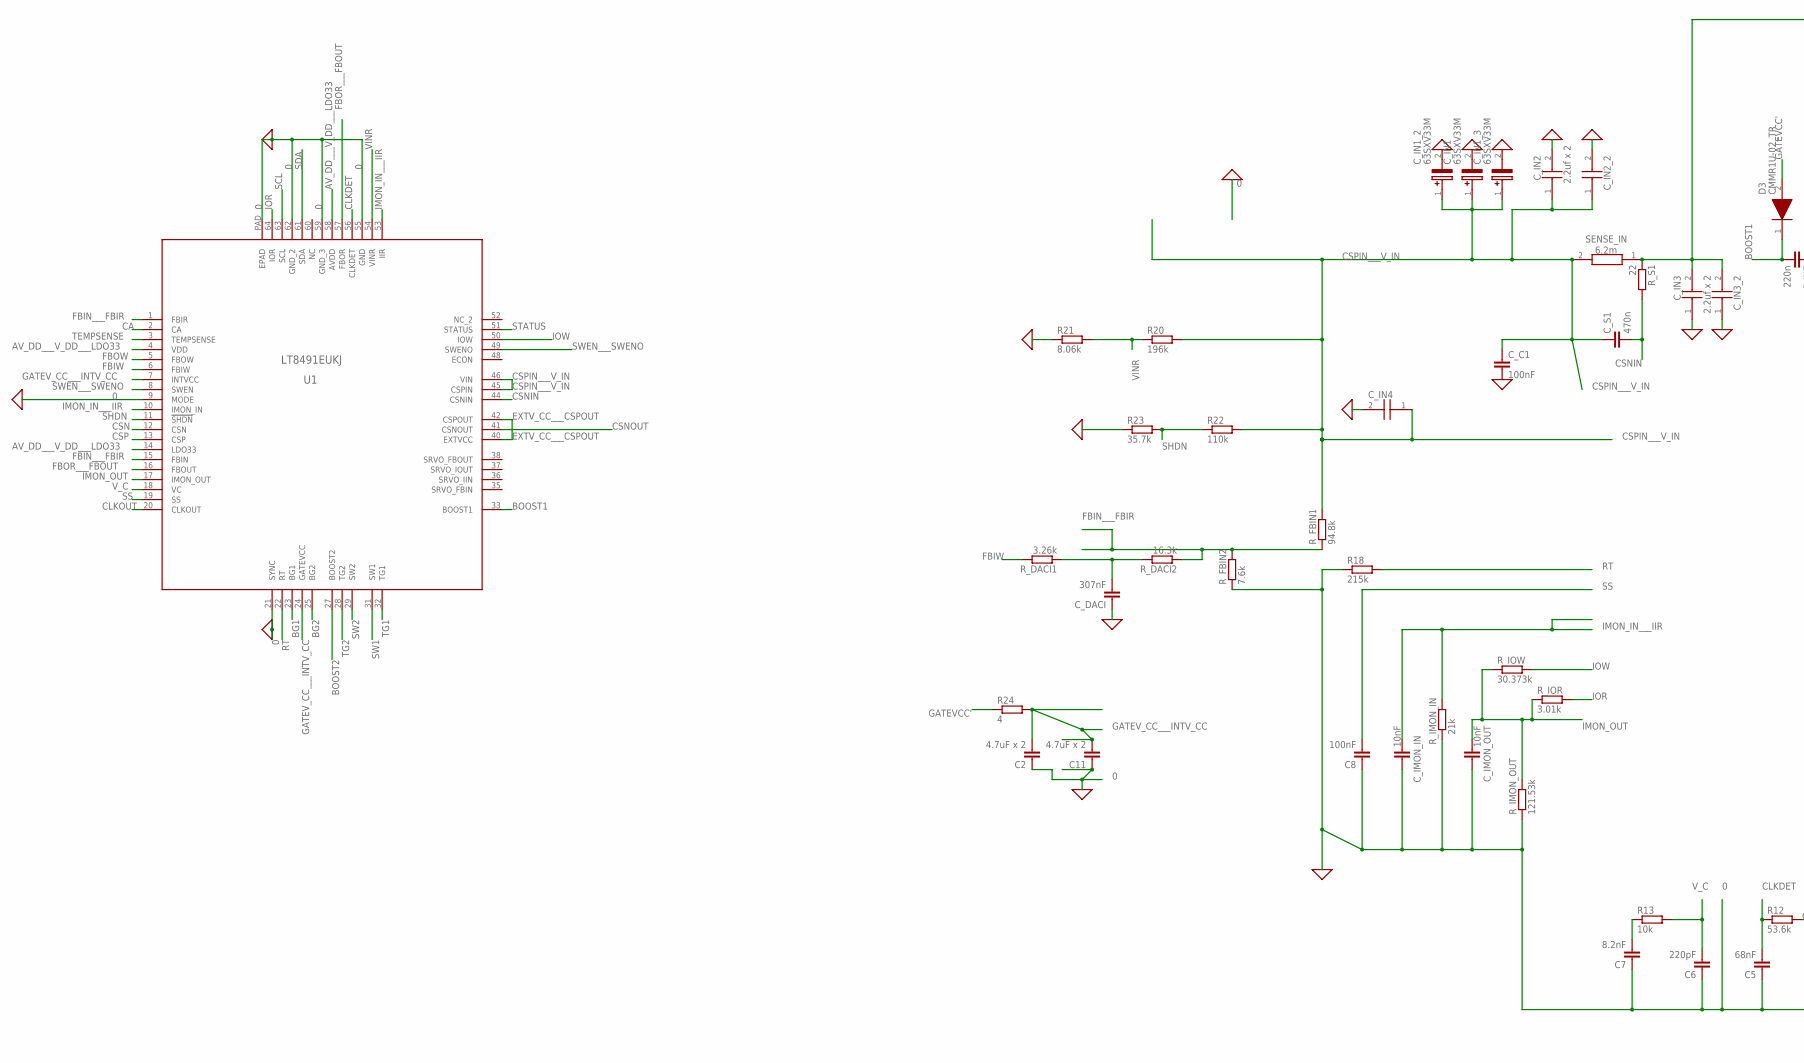
[picture p16: schematic Solar Charge Controller_ver2.sch, part in row 1, column 1]

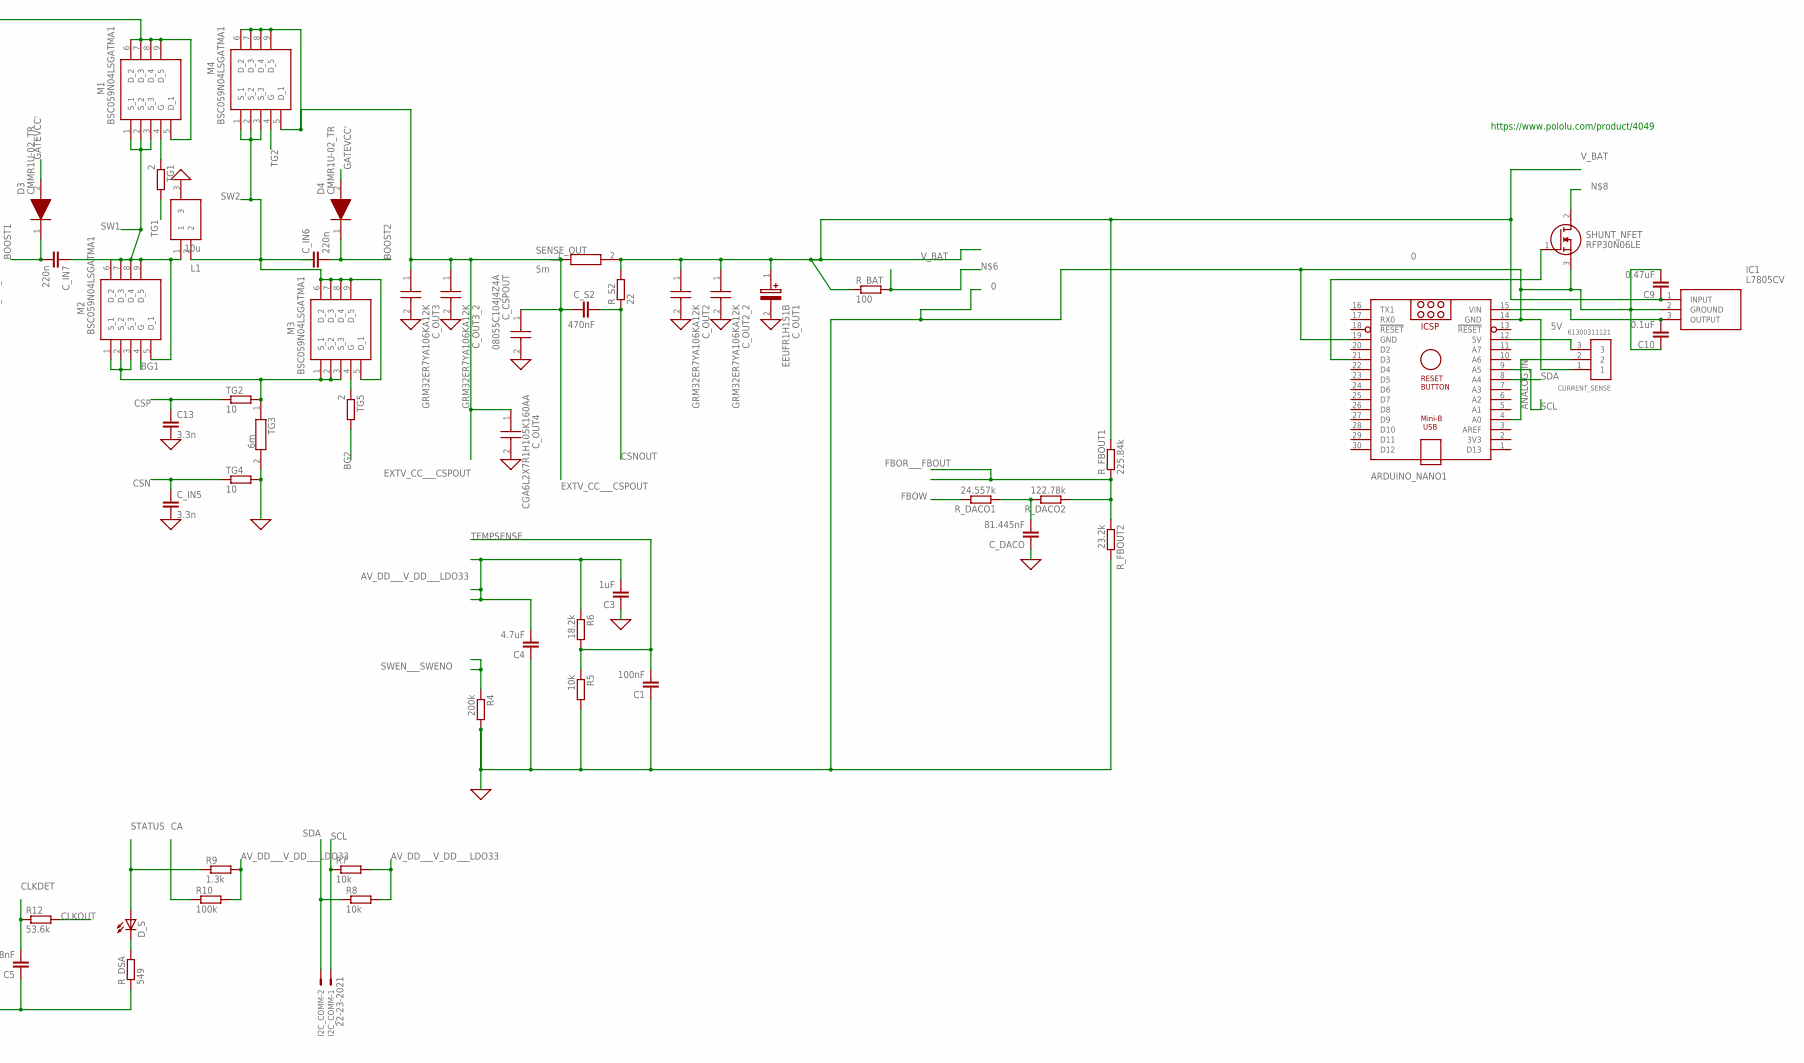
[picture p17: schematic Solar Charge Controller_ver2.sch, part in row 1, column 2]

Parts:
ARDUINO_NANO1: ARDUINO_NANO
C1, C8: 100nF; C1206
C2, C11: 4.7uF x 2; C1206
C3: 1uF; C1206
C4: 4.7uF; C1206
C5: 68nF; C0603
C6: 220pF; C1206
C7: 8.2nF; C1206
C9: 0.47uF; C1206
C10: 0.1uF; C1206
C13: 3.3n; C1206
CURRENT_SENSE: 61300311121
C_C1: 100nF; C1206
C_CSPOUT: 08055C104J4Z4A; CAPC2012X127N
C_DACI: 307nF; C1206
C_DACO: 81.445nF; C1206
C_IMON_IN: 10nF; C1206
C_IMON_OUT: 10nF; C1206
C_IN1, C_IN1_2, C_IN1_3: 63SXV33M; CAPAE830X1200N
C_IN2, C_IN2_2, C_IN3, C_IN3_2: 2.2uf x 2; CAPC3325X279N
C_IN4: 2.2uf; CAPC3325X279N
C_IN5: 3.3n; C1206
C_IN6, C_IN7: 220n; C1206
C_OUT1: EEUFR1H151B; CAPPRD500W65D1000H1400
C_OUT2, C_OUT2_2, C_OUT3, C_OUT3_2: GRM32ER7YA106KA12K; CAPC3225X270N
C_OUT4: CGA6L2X7R1H105K160AA; CAPC3225X280N
C_S1: 470n; C1206
C_S2: 470nF; C1206
D3, D4: CMMR1U-02_TR; SODFL3818X108N
D_S: LED_E; LED_1206
I2C_COMM: 22-23-2021
IC1: L7805CV; TO255P460X1020X2008-3P
L1: 10u; SER2900
M1, M2, M3, M4: BSC059N04LSGATMA1; BSC080N03LSG
R4: 200k; R1206
R5, R7, R8, R13: 10k; R1206
R6: 18.2k; R1206
R9: 1.3k; R1206
R10: 100k; R1206
R12: 53.6k; R1206
R18: 215k; R1206
R20: 196k; R1206
R21: 8.06k; R1206
R22: 110k; R1206
R23: 35.7k; R1206
R24: 4; R1206
R_BAT: 100; R1206
R_DACI1: 3.26k; R1206
R_DACI2: 16.3k; R1206
R_DACO1: 24.557k; R1206
R_DACO2: 122.78k; R1206
R_DSA: 549; R1206
R_FBIN1: 94.8k; R1206
R_FBIN2: 7.6k; R1206
R_FBOUT1: 225.84k; R1206
R_FBOUT2: 23.2k; R1206
R_IMON_IN: 21k; R1206
R_IMON_OUT: 121.53k; R1206
R_IOR: 3.01k; R1206
R_IOW: 30.373k; R1206
R_S1, R_S2: 22; R1206
SENSE_IN: 6.2m; RESC2012X80N
SENSE_OUT: 5m; RESC3216X89N
SHUNT_NFET: RFP30N06LE; TO254P470X1016X2019-3P
TG1, TG5: 2; R1206
TG2, TG4: 10; R1206
TG3: 6m; RESC2012X80N
U1: LT8491EUKJ; QFN64(58)-UKJ-REV0_ADI

Connections:
0: ARDUINO_NANO1.14 (GND), ARDUINO_NANO1.19 (GND), C1.1, C2.1, C3.1, C4.1, C5.1, C6.1, C7.1, C8.1, C9.2, C10.1, C11.1, C13.2, CURRENT_SENSE.1, C_C1.2, C_CSPOUT.2, C_DACI.1, C_DACO.1, C_IMON_IN.1, C_IMON_OUT.1, C_IN1.2 (-), C_IN1_2.2 (-), C_IN1_3.2 (-), C_IN2.2, C_IN2_2.2, C_IN3.1, C_IN3_2.1, C_IN4.2, C_IN5.2, C_OUT1.2 (-), C_OUT2.2, C_OUT2_2.2, C_OUT3.2, C_OUT3_2.2, C_OUT4.2, IC1.2 (GROUND), L1.3, R4.2, R5.2, R18.1, R21.1, R23.1, R_DSA.1, R_FBIN2.1, R_FBOUT2.2, R_IMON_IN.1, R_IMON_OUT.1, SHUNT_NFET.3 (S), TG3.2, TG4.2, U1.9 (MODE), U1.21 (SYNC), U1.55 (GND), U1.59 (GND_3), U1.62 (GND_2), U1.PAD (EPAD)
5V: ARDUINO_NANO1.12 (5V), CURRENT_SENSE.3
ANALOG_IN: ARDUINO_NANO1.4 (A0), CURRENT_SENSE.2
AV_DD___V_DD___LDO33: C3.2, C4.2, R6.1, R7.2, R8.2, R9.2, R10.2, U1.4 (VDD), U1.14 (LDO33), U1.58 (AVDD)
BG1: M2.4 (G), U1.23 (BG1)
BG2: TG5.2, U1.25 (BG2)
BOOST1: C_IN7.2, D3.1 (K), U1.33 (BOOST1)
BOOST2: C_IN6.2, D4.1 (K), U1.27 (BOOST2)
CA: R10.1, U1.2 (CA)
CLKDET: C5.2, R12.1, U1.56 (CLKDET)
CLKOUT: R12.2, U1.20 (CLKOUT)
CSN: C_IN5.1, TG4.1, U1.12 (CSN)
CSNIN: C_S1.2, R_S1.2, U1.44 (CSNIN)
CSNOUT: C_S2.2, R_S2.1, U1.41 (CSNOUT)
CSP: C13.1, TG2.1, U1.13 (CSP)
CSPIN___V_IN: C_C1.1, C_IN1.1 (+), C_IN1_2.1 (+), C_IN1_3.1 (+), C_IN2.1, C_IN2_2.1, C_IN4.1, C_S1.1, R20.2, R22.2, R_FBIN1.2, SENSE_IN.2, U1.45 (CSPIN), U1.46 (VIN)
EXTV_CC___CSPOUT: C_CSPOUT.1, C_OUT3.1, C_OUT3_2.1, C_OUT4.1, C_S2.1, M4.5 (D_1), M4.6 (D_2), M4.7 (D_3), M4.8 (D_4), M4.9 (D_5), SENSE_OUT.1, U1.40 (EXTVCC), U1.42 (CSPOUT)
FBIN___FBIR: R_DACI2.1, R_FBIN1.1, R_FBIN2.2, U1.1 (FBIR), U1.15 (FBIN)
FBIW: R_DACI1.2, U1.6 (FBIW)
FBOR___FBOUT: R_DACO2.1, R_FBOUT1.1, R_FBOUT2.1, U1.16 (FBOUT), U1.57 (FBOR)
FBOW: R_DACO1.2, U1.5 (FBOW)
GATEVCC': D3.2 (A), D4.2 (A), R24.1
GATEV_CC___INTV_CC: C2.2, C11.2, R24.2, U1.7 (INTVCC), U1.24 (GATEVCC)
IMON_IN___IIR: C_IMON_IN.2, R_IMON_IN.2, U1.10 (IMON_IN), U1.53 (IIR)
IMON_OUT: C_IMON_OUT.2, R_IMON_OUT.2, R_IOR.1, R_IOW.1, U1.17 (IMON_OUT)
IOR: R_IOR.2, U1.64 (IOR)
IOW: R_IOW.2, U1.50 (IOW)
unnamed: C_IN3.2, C_IN3_2.2, M1.5 (D_1), M1.6 (D_2), M1.7 (D_3), M1.8 (D_4), M1.9 (D_5), R_S1.1, SENSE_IN.1
unnamed: M2.1 (S_1), M2.2 (S_2), M2.3 (S_3), M3.1 (S_1), M3.2 (S_2), M3.3 (S_3), TG2.2, TG3.1
unnamed: M1.4 (G), TG1.1
unnamed: C_DACI.2, R_DACI1.1, R_DACI2.2
unnamed: M3.4 (G), TG5.1
unnamed: ARDUINO_NANO1.15 (VIN), C10.2, IC1.3 (OUTPUT)
unnamed: ARDUINO_NANO1.21 (D3), SHUNT_NFET.1 (G)
unnamed: C_DACO.2, R_DACO1.1, R_DACO2.2
unnamed: D_S.C, R_DSA.2
unnamed: C7.2, R13.1
RT: R18.2, U1.22 (RT)
SCL: ARDUINO_NANO1.9 (A5), I2C_COMM.1, R7.1, U1.63 (SCL)
SDA: ARDUINO_NANO1.8 (A4), I2C_COMM.2, R8.1, U1.61 (SDA)
SHDN: R22.1, R23.2, U1.11 (!SHDN)
SS: C8.2, U1.19 (SS)
STATUS: D_S.A, R9.1, U1.51 (STATUS)
SW1: C_IN7.1, L1.1, M1.1 (S_1), M1.2 (S_2), M1.3 (S_3), M2.5 (D_1), M2.6 (D_2), M2.7 (D_3), M2.8 (D_4), M2.9 (D_5), U1.31 (SW1)
SW2: C_IN6.1, L1.2, M3.5 (D_1), M3.6 (D_2), M3.7 (D_3), M3.8 (D_4), M3.9 (D_5), M4.1 (S_1), M4.2 (S_2), M4.3 (S_3), U1.29 (SW2)
SWEN___SWENO: R4.1, U1.8 (SWEN), U1.49 (SWENO)
TEMPSENSE: C1.2, R5.1, R6.2, U1.3 (TEMPSENSE)
TG1: TG1.2, U1.32 (TG1)
TG2: M4.4 (G), U1.28 (TG2)
VINR: R20.1, R21.2, U1.54 (VINR)
V_BAT: C9.1, C_OUT1.1 (+), C_OUT2.1, C_OUT2_2.1, IC1.1 (INPUT), R_BAT.1, R_FBOUT1.2, R_S2.2, SENSE_OUT.2
V_C: C6.2, R13.2, U1.18 (VC)

Notes on the sheet:
https://www.pololu.com/product/4049

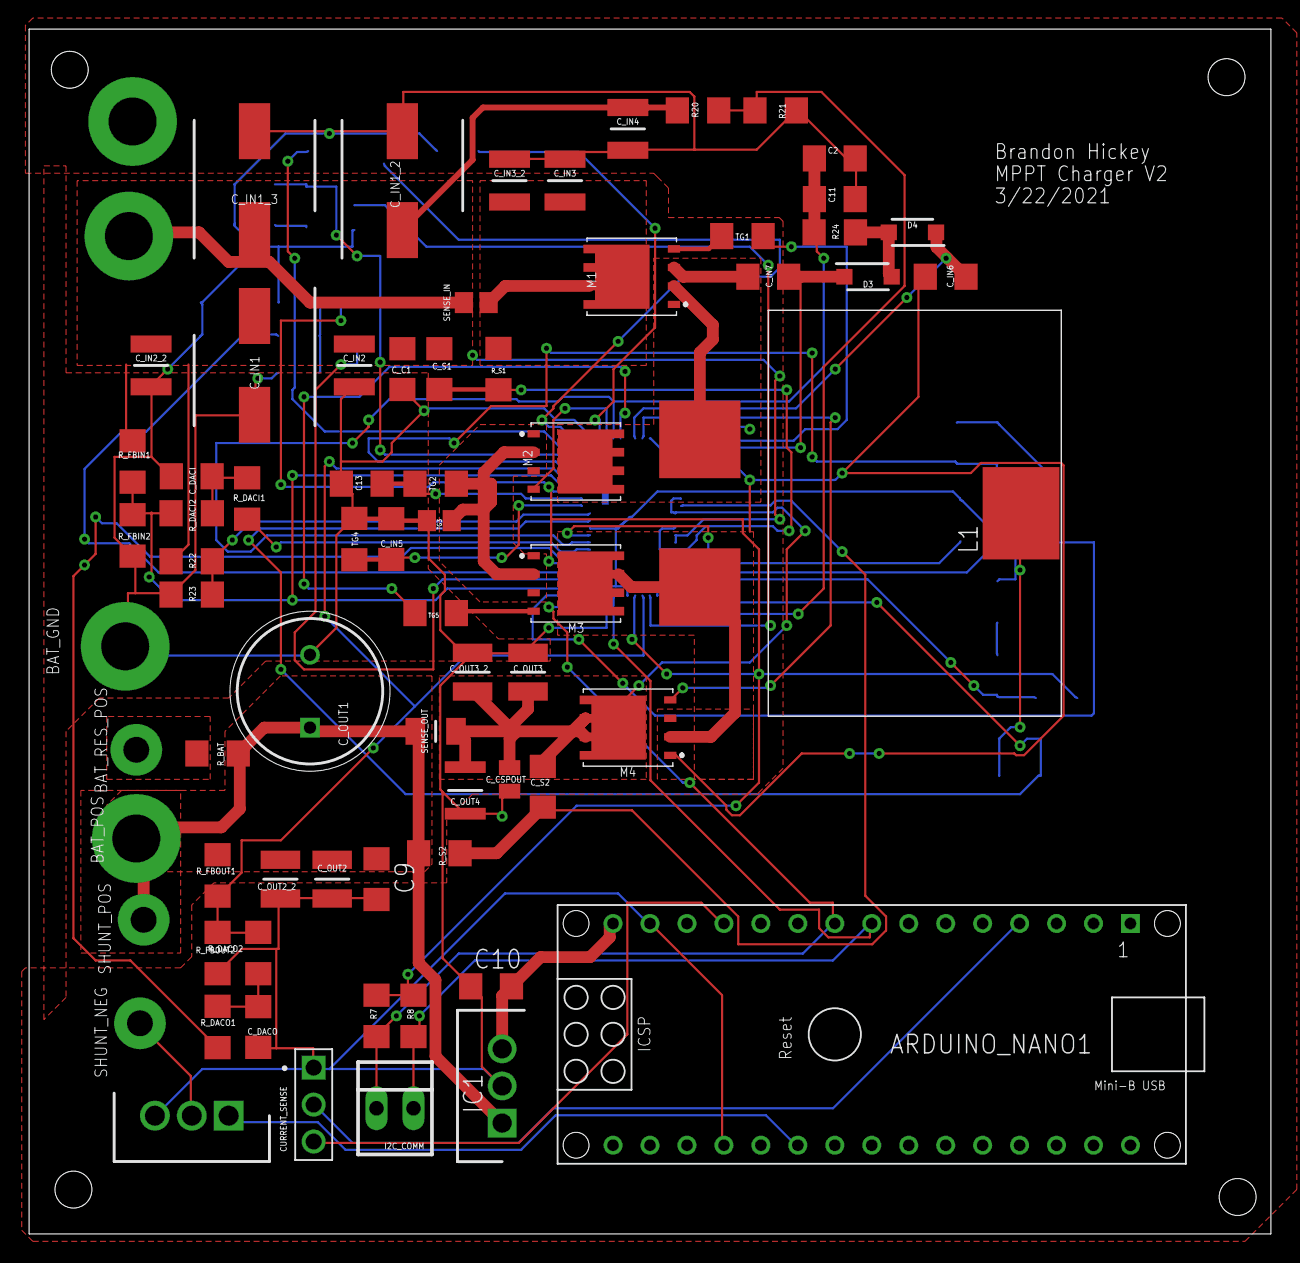
[picture p18: board Solar Charge Controller_ver2.brd from above]

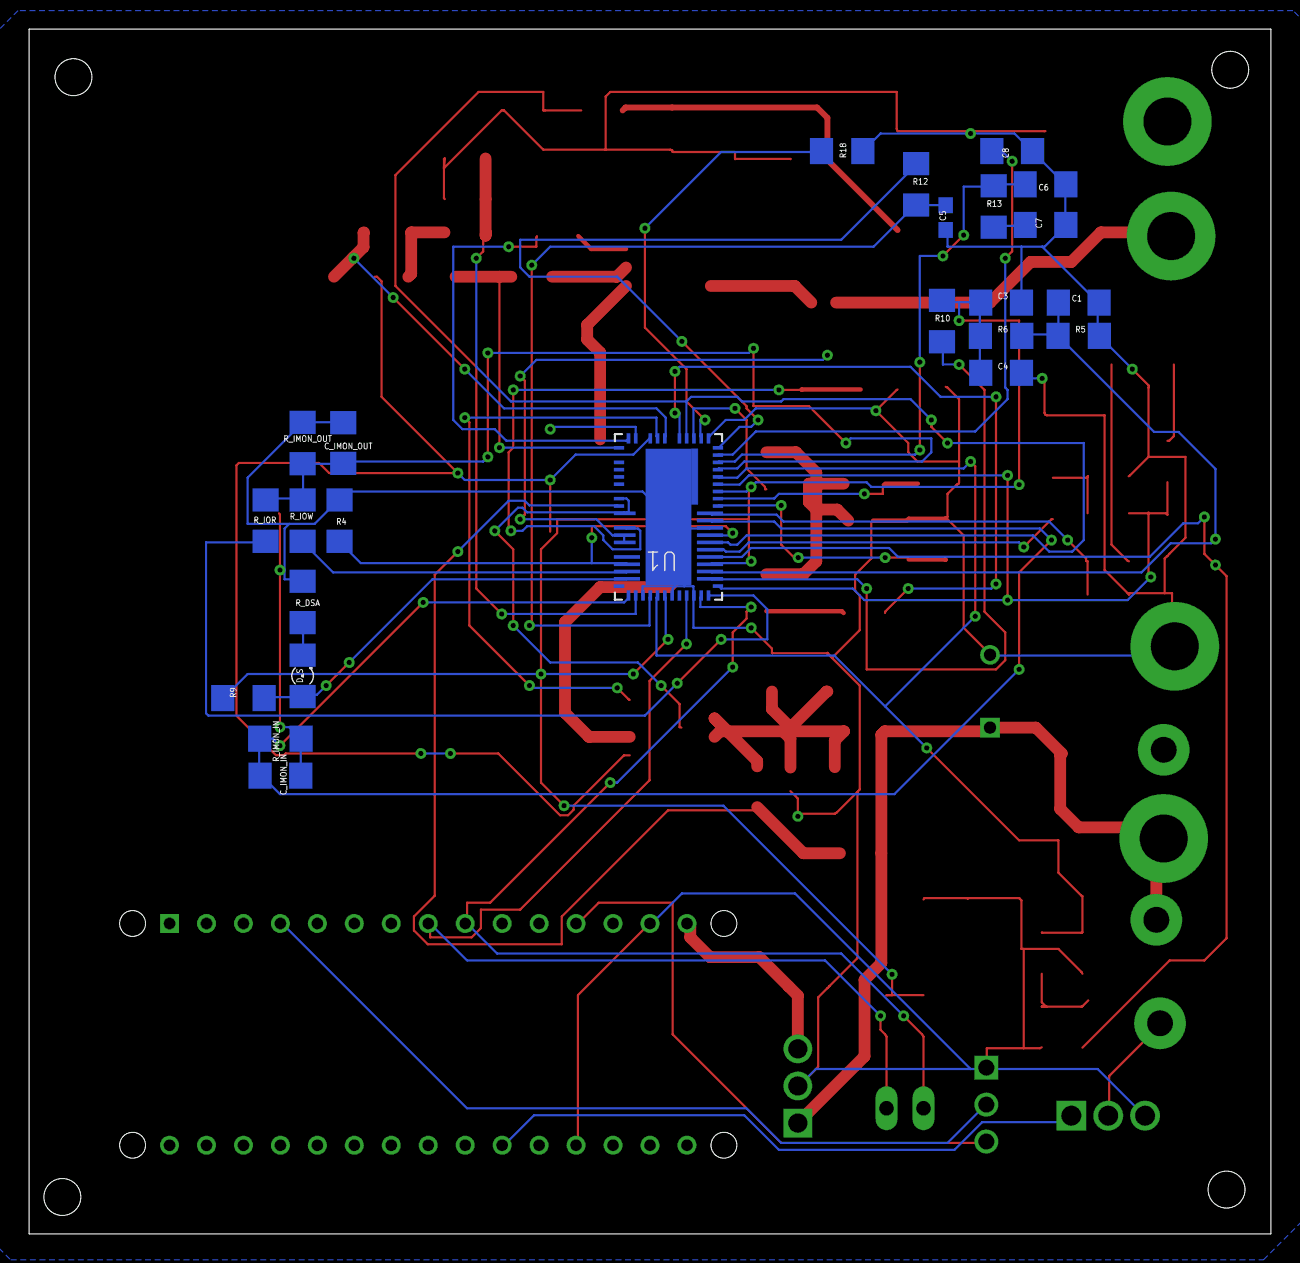
[picture p19: board Solar Charge Controller_ver2.brd from below]

Board: 2 copper layers, 85.3 x 82.8 mm, 89 parts (24 on the bottom side), 52 nets.
