Brandonh291/MRE481-Senior-Capstone-Project-Solar-Plane/(notices)

Notices in the files:
parts and their libraries:
COPYRIGHT: Copyright (C) 2018 Accelerated Designs. All rights reserved
